bnamnaidu/HL2-Companion-board-codec-and-Filter-/HL2_Companion.kicad_pcb

## KiCad design HL2_Companion.kicad_pcb (2018-02-08)

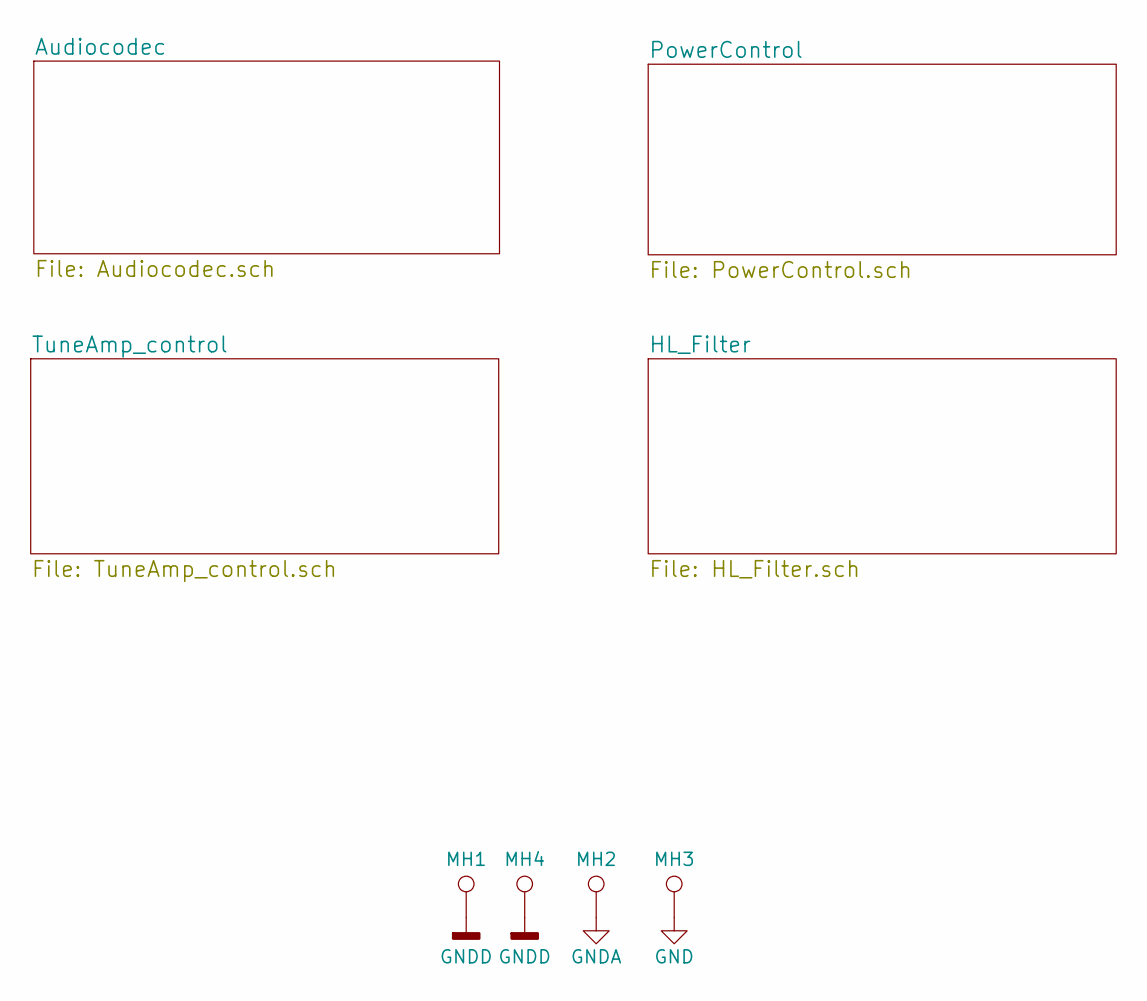
[picture p6: schematic HL2_Companion.sch, HL2Beta5_Companion]

Parts:
MH1, MH2, MH3, MH4: TEST_1P; m3

Connections:
GND: MH3.1; also elsewhere on the board
GNDA: MH2.1; also elsewhere on the board
GNDD: MH1.1, MH4.1; also elsewhere on the board

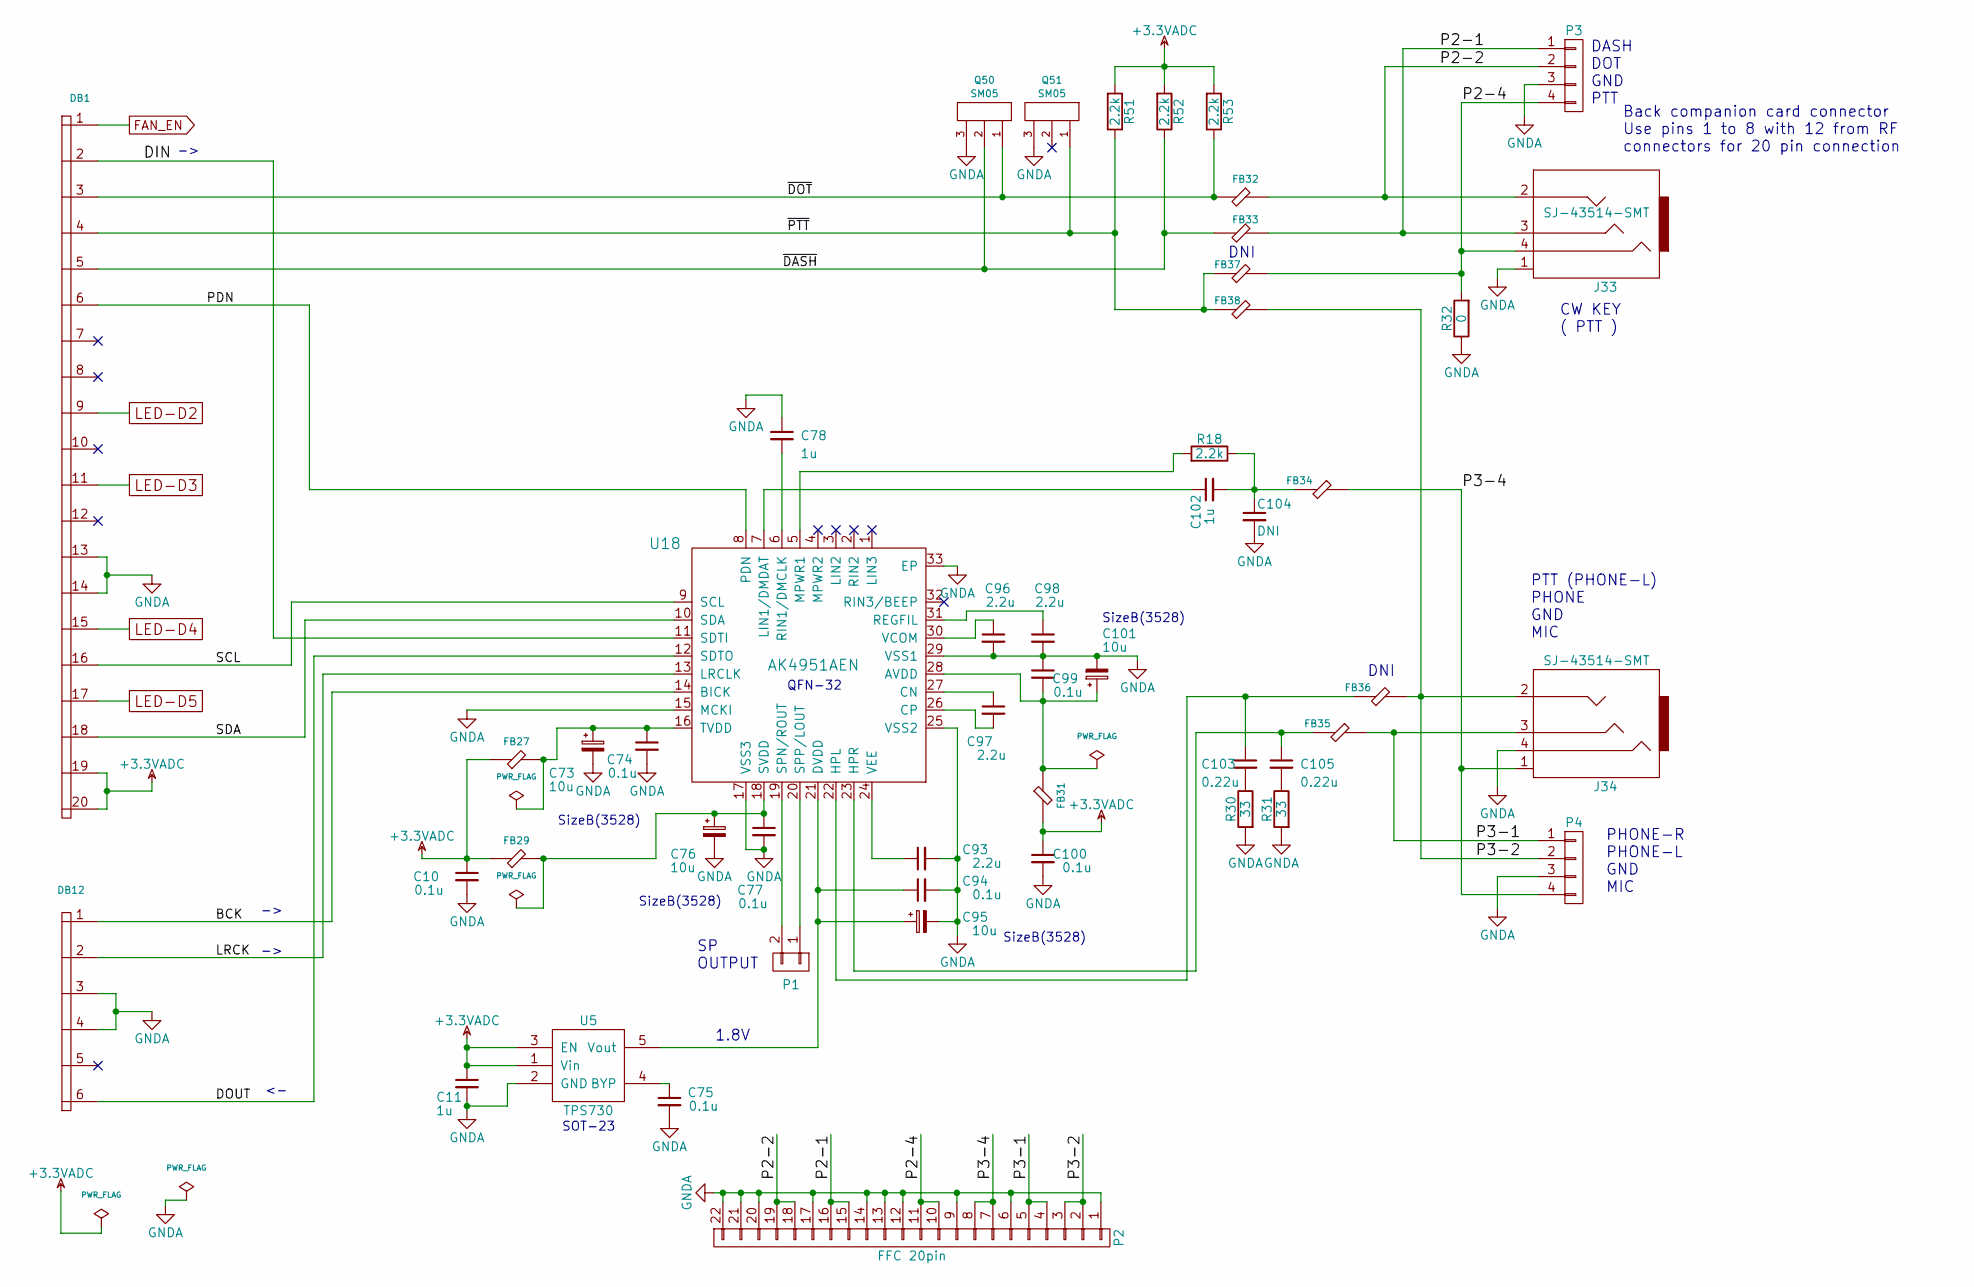
[picture p7: schematic Audiocodec.sch, H-L v2 Companion - AK4951]

Parts:
C10, C74, C75, C77, C94, C99, C100: 0.1u; C_0603_HandSoldering
C11, C78, C102: 1u; C_0603_HandSoldering
C73, C76, C95, C101: 10u; TantalC_SizeB_EIA-3528_Wave
C93, C96, C97, C98: 2.2u; C_0603_HandSoldering
C103, C105: 0.22u; C_0603_HandSoldering
C104: DNI; C_0603_HandSoldering
DB1: IO20; 10x2
DB12: IO6b; 3x2
FB27, FB29, FB31, FB32, FB33, FB34, FB35, FB36, FB37, FB38: FB; C_0603_HandSoldering
J33, J34: SJ-43514-SMT
P1: CONN_01X02; Pin_Header_Straight_1x02_Pitch2.54mm
P2: FFC 20pin; FFC_Kyocera_20pin
P3, P4: CONN_01X04; Pin_Header_Straight_1x04_Pitch2.54mm
Q50, Q51: SM05; SOT-23
R18, R51, R52, R53: 2.2k; C_0603_HandSoldering
R30, R31: 33; C_0603_HandSoldering
R32: 0; C_0603_HandSoldering
U5: TPS730; SOT23
U18: AK4951AEN; QFN-32-1EP_4x4mm_Pitch0.4mm_Handsoldering

Connections:
+3.3VADC: C10.1, C11.1, C100.1, DB1.19, DB1.20, FB27.2, FB29.2, FB31.1, R51.2, R52.2, R53.2, U5.1 (Vin), U5.3 (EN)
/Audiocodec/BCK: DB12.1, U18.14 (BICK)
/Audiocodec/DIN: DB1.2, U18.11 (SDTI)
/Audiocodec/DOUT: DB12.6, U18.12 (SDTO)
/Audiocodec/LRCK: DB12.2, U18.13 (LRCLK)
/Audiocodec/P2-1: FB33.2, J33.3, P2.15, P2.16, P3.1
/Audiocodec/P2-2: FB32.2, J33.2, P2.18, P2.19, P3.2
/Audiocodec/P2-4: FB37.1, J33.4, P2.10, P2.11, P3.4, R32.2
/Audiocodec/P3-1: FB35.2, J34.3, P2.4, P2.5, P4.1
/Audiocodec/P3-2: FB36.1, FB38.1, J34.2, P2.2, P2.3, P4.2
/Audiocodec/P3-4: FB34.2, J34.1, P2.7, P2.8, P4.4
/Audiocodec/PDN: DB1.6, U18.8 (PDN)
/Audiocodec/SCL: DB1.16, U18.9 (SCL)
/Audiocodec/SDA: DB1.18, U18.10 (SDA)
/Audiocodec/~DASH: DB1.5, FB33.1, Q50.2, R52.1
/Audiocodec/~DOT: DB1.3, FB32.1, Q50.1, R53.1
/Audiocodec/~PTT: DB1.4, FB37.2, FB38.2, Q51.1, R51.1
FAN_EN: DB1.1; also elsewhere on the board
GNDA: C10.2, C11.2, C73.2, C74.2, C75.2, C76.2, C77.2, C78.1, C93.2, C94.2, C95.2, C96.2, C98.2, C99.1, C100.2, C101.2, C104.2, DB1.13, DB1.14, DB12.3, DB12.4, J33.1, J34.4, P2.1, P2.6, P2.9, P2.12, P2.13, P2.14, P2.17, P2.20, P2.21, P2.22, P3.3, P4.3, Q50.3, Q51.3, R30.2, R31.2, R32.1, U5.2 (GND), U18.15 (MCKI), U18.17 (VSS3), U18.25 (VSS2), U18.29 (VSS1), U18.33 (EP); also elsewhere on the board
LED-D2: DB1.9; also elsewhere on the board
LED-D3: DB1.11; also elsewhere on the board
LED-D4: DB1.15; also elsewhere on the board
LED-D5: DB1.17; also elsewhere on the board
unnamed: C73.1, C74.1, FB27.1, U18.16 (TVDD)
unnamed: C75.1, U5.4 (BYP)
unnamed: C76.1, C77.1, FB29.1, U18.18 (SVDD)
unnamed: C78.2, U18.6 (RIN1/DMCLK)
unnamed: C93.1, U18.24 (VEE)
unnamed: C94.1, C95.1, U5.5 (Vout), U18.21 (DVDD)
unnamed: C96.1, U18.30 (VCOM)
unnamed: C97.1, U18.27 (CN)
unnamed: C97.2, U18.26 (CP)
unnamed: C98.1, U18.31 (REGFIL)
unnamed: C99.2, C101.1, FB31.2, U18.28 (AVDD)
unnamed: C102.1, U18.7 (LIN1/DMDAT)
unnamed: C102.2, C104.1, FB34.1, R18.1
unnamed: C103.1, FB36.2, U18.22 (HPL)
unnamed: C103.2, R30.1
unnamed: C105.1, FB35.1, U18.23 (HPR)
unnamed: C105.2, R31.1
unnamed: P1.1, U18.20 (SPP/LOUT)
unnamed: P1.2, U18.19 (SPN/ROUT)
unnamed: R18.2, U18.5 (MPWR1)

Notes on the sheet:
Back companion card connector Use pins 1 to 8 with 12 from RF connectors for 20 pin connection
SP OUTPUT
CW KEY ( PTT )
PTT (PHONE-L) PHONE GND MIC
1.8V
DNI
PHONE-R PHONE-L GND MIC
DASH DOT GND PTT
SizeB(3528)
SOT-23
QFN-32

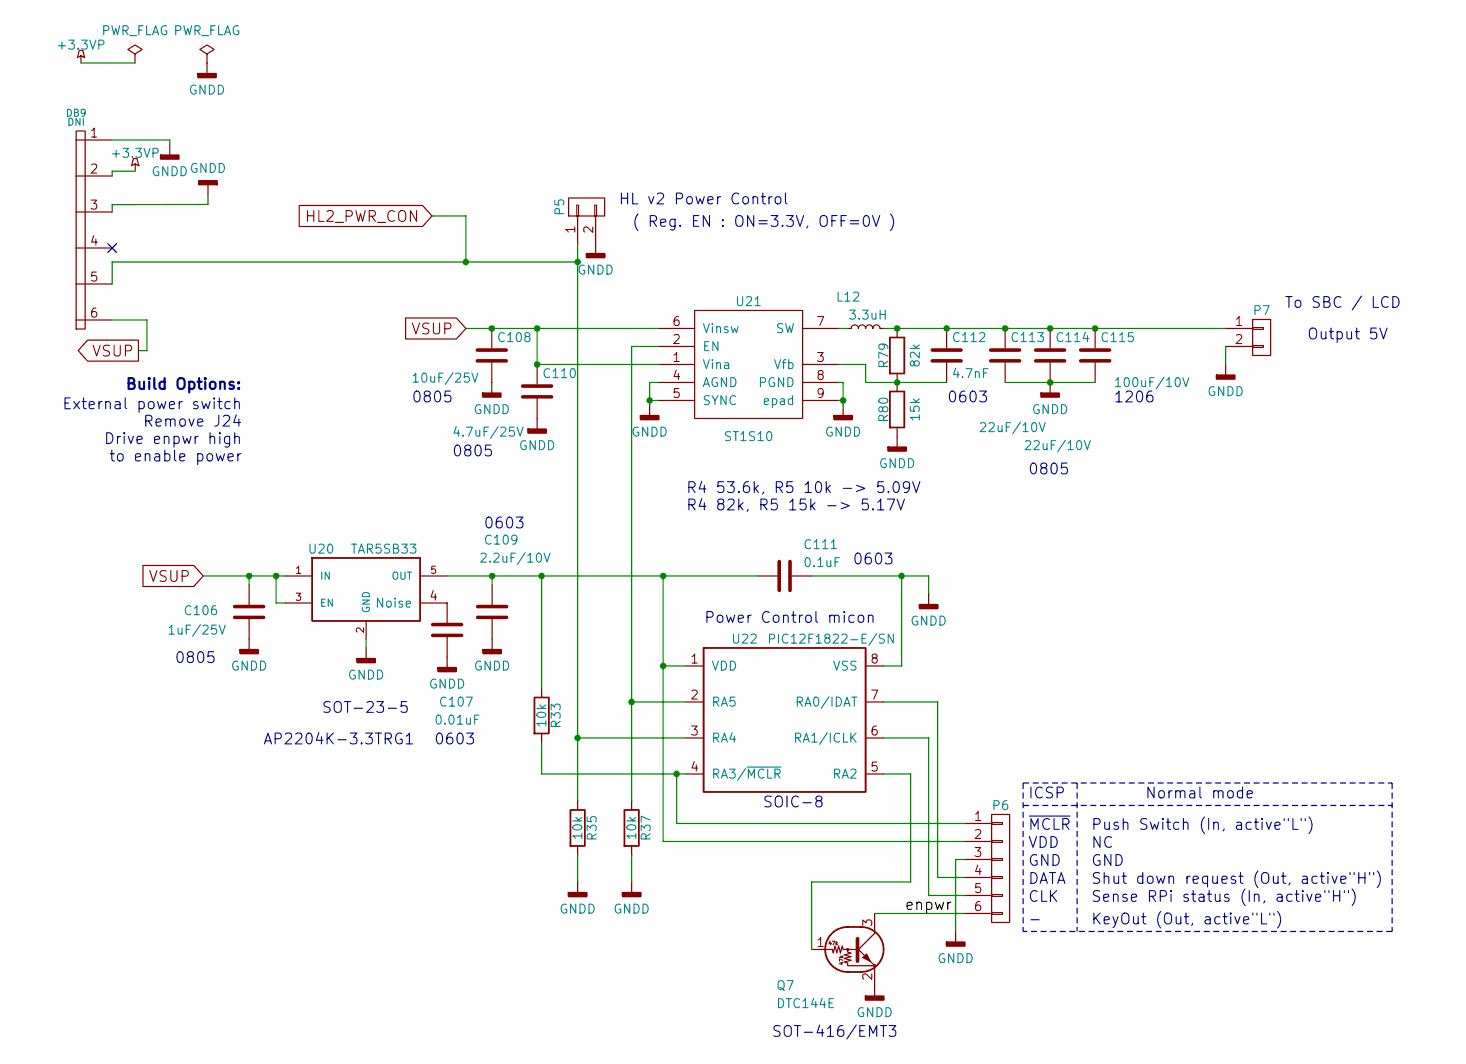
[picture p8: schematic PowerControl.sch, HL2Beta5_ PwrControl]

Parts:
C106: 1uF/25V; SMD-0805
C107: 0.01uF; SMD-0603
C108: 10uF/25V; SMD-0805
C109: 2.2uF/10V; SMD-0603
C110: 4.7uF/25V; SMD-0805
C111: 0.1uF; SMD-0603
C112: 4.7nF; SMD-0603
C113, C114: 22uF/10V; SMD-0805
C115: 100uF/10V; SMD-1206
DB9: IO6b; 6x1
L12: 3.3uH; GENERICPSL
P5: CONN_01X02; Pin_Header_Straight_1x02_Pitch2.54mm
P6: CONN_01X06; Pin_Header_Straight_1x06_Pitch2.54mm
P7: CONN_01X02; PINHEAD1-2
Q7: DTC144E; SOT416
R33, R35, R37: 10k; SMD-0603
R79: 82k; SMD-0603
R80: 15k; SMD-0603
U20: TAR5SB33; SOT-23-5
U21: ST1S10
U22: PIC12F1822-E/SN; SOIC-8_3.9x4.9mm_Pitch1.27mm

Connections:
+3.3VP: DB9.2; also elsewhere on the board
/PowerControl/enpwr: P6.6, Q7.3 (C)
GNDD: C106.2, C107.2, C108.2, C109.2, C110.2, C111.1, C113.2, C114.2, C115.2, DB9.1, DB9.3, P5.2, P6.3, P7.2, Q7.2 (E), R35.2, R37.2, R80.2, U20.2 (GND), U21.4 (AGND), U21.5 (SYNC), U21.8 (PGND), U21.9 (epad), U22.8 (VSS); also elsewhere on the board
HL2_PWR_CON: DB9.5, P5.1, R35.1, U22.3 (RA4); also elsewhere on the board
unnamed: C107.1, U20.4 (Noise)
unnamed: C109.1, C111.2, P6.2, R33.1, U20.5 (OUT), U22.1 (VDD)
unnamed: C112.1, C113.1, C114.1, C115.1, L12.1, P7.1, R79.1
unnamed: C112.2, R79.2, R80.1, U21.3 (Vfb)
unnamed: L12.2, U21.7 (SW)
unnamed: P6.1, R33.2, U22.4 (RA3/~MCLR)
unnamed: P6.4, U22.7 (RA0/IDAT)
unnamed: P6.5, U22.6 (RA1/ICLK)
unnamed: Q7.1 (B), U22.5 (RA2)
unnamed: R37.1, U21.2 (EN), U22.2 (RA5)
VSUP: C106.1, C108.1, C110.1, DB9.6, U20.1 (IN), U20.3 (EN), U21.1 (Vina), U21.6 (Vinsw); also elsewhere on the board

Notes on the sheet:
To SBC / LCD
ICSP
~MCLR
VDD
GND
DATA
CLK
Shut down request (Out, active"H")
Sense RPi status (In, active"H")
Output 5V
Normal mode
Push Switch (In, active"L")
HL v2 Power Control
( Reg. EN : ON=3.3V, OFF=0V )
Power Control micon
SOT-23-5
SOIC-8
0805
1206
0603
SOT-416/EMT3
R4 53.6k, R5 10k -> 5.09V R4 82k, R5 15k -> 5.17V
AP2204K-3.3TRG1
KeyOut (Out, active"L")
Build Options:
External power switch Remove J24 Drive enpwr high to enable power

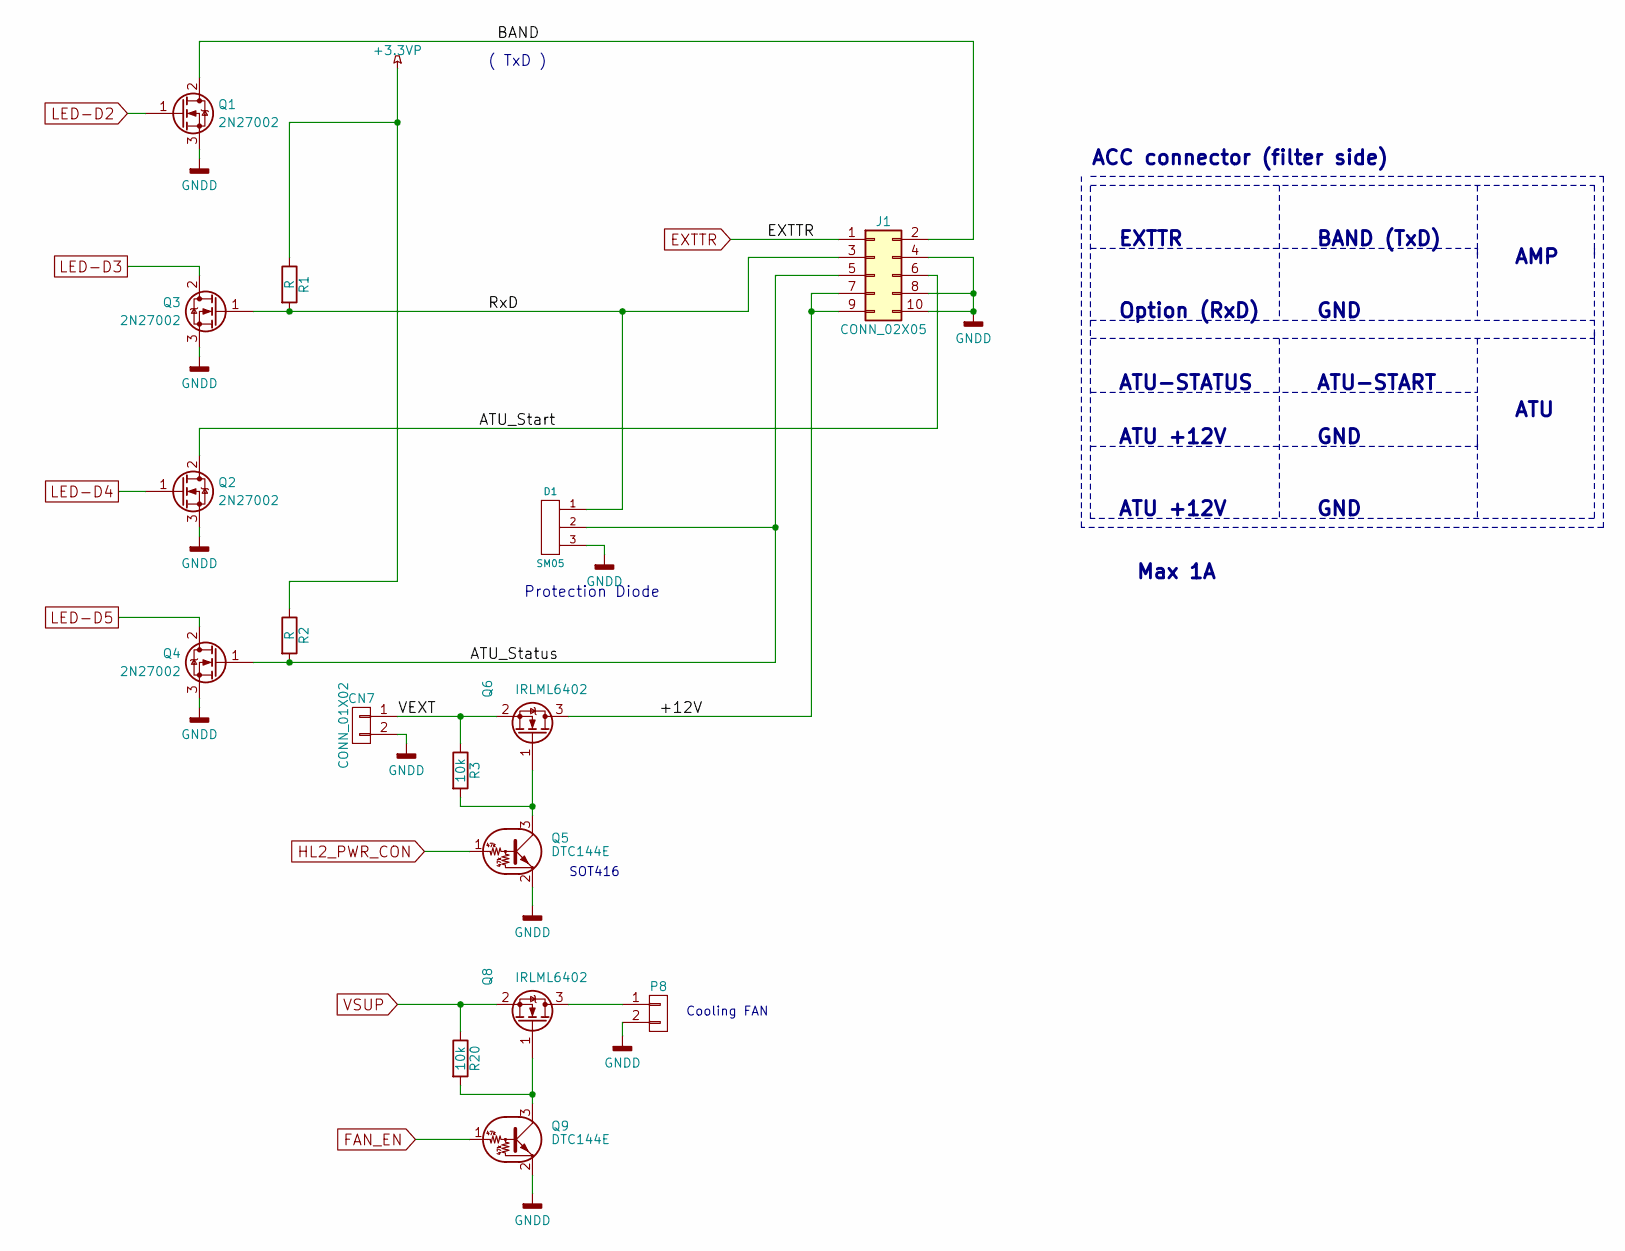
[picture p9: schematic TuneAmp_control.sch, HL2 Companion/Tuner Amplifier Control]

Parts:
CN7: CONN_01X02; CN7
D1: SM05; SOT-23
J1: CONN_02X05; 5x2
P8: CONN_01X02; PINHEAD1-2
Q1, Q2, Q3, Q4: 2N27002; SOT-23
Q5, Q9: DTC144E; SOT416
Q6, Q8: IRLML6402; SOT23_3
R1, R2: R; C_0603_HandSoldering
R3, R20: 10k; C_0603_HandSoldering

Connections:
+3.3VP: R1.1, R2.1; also elsewhere on the board
/TuneAmp_control/+12V: J1.7, J1.9, Q6.3 (D)
/TuneAmp_control/ATU_Start: J1.6, Q2.2 (D)
/TuneAmp_control/ATU_Status: D1.2, J1.5, Q4.1 (G), R2.2
/TuneAmp_control/BAND: J1.2, Q1.2 (D)
/TuneAmp_control/RxD: D1.1, J1.3, Q3.1 (G), R1.2
/TuneAmp_control/VEXT: CN7.1, Q6.2 (S), R3.1
EXTTR: J1.1; also elsewhere on the board
FAN_EN: Q9.1 (B); also elsewhere on the board
GNDD: CN7.2, D1.3, J1.4, J1.8, J1.10, P8.2, Q1.3 (S), Q2.3 (S), Q3.3 (S), Q4.3 (S), Q5.2 (E), Q9.2 (E); also elsewhere on the board
HL2_PWR_CON: Q5.1 (B); also elsewhere on the board
LED-D2: Q1.1 (G); also elsewhere on the board
LED-D3: Q3.2 (D); also elsewhere on the board
LED-D4: Q2.1 (G); also elsewhere on the board
LED-D5: Q4.2 (D); also elsewhere on the board
unnamed: P8.1, Q8.3 (D)
unnamed: Q5.3 (C), Q6.1 (G), R3.2
unnamed: Q8.1 (G), Q9.3 (C), R20.2
VSUP: Q8.2 (S), R20.1; also elsewhere on the board

Notes on the sheet:
( TxD )
Protection Diode
EXTTR
BAND (TxD)
Option (RxD)
GND
AMP
ATU-STATUS
ATU-START
ATU +12V
ATU
Max 1A
ACC connector (filter side)
SOT416
Cooling FAN

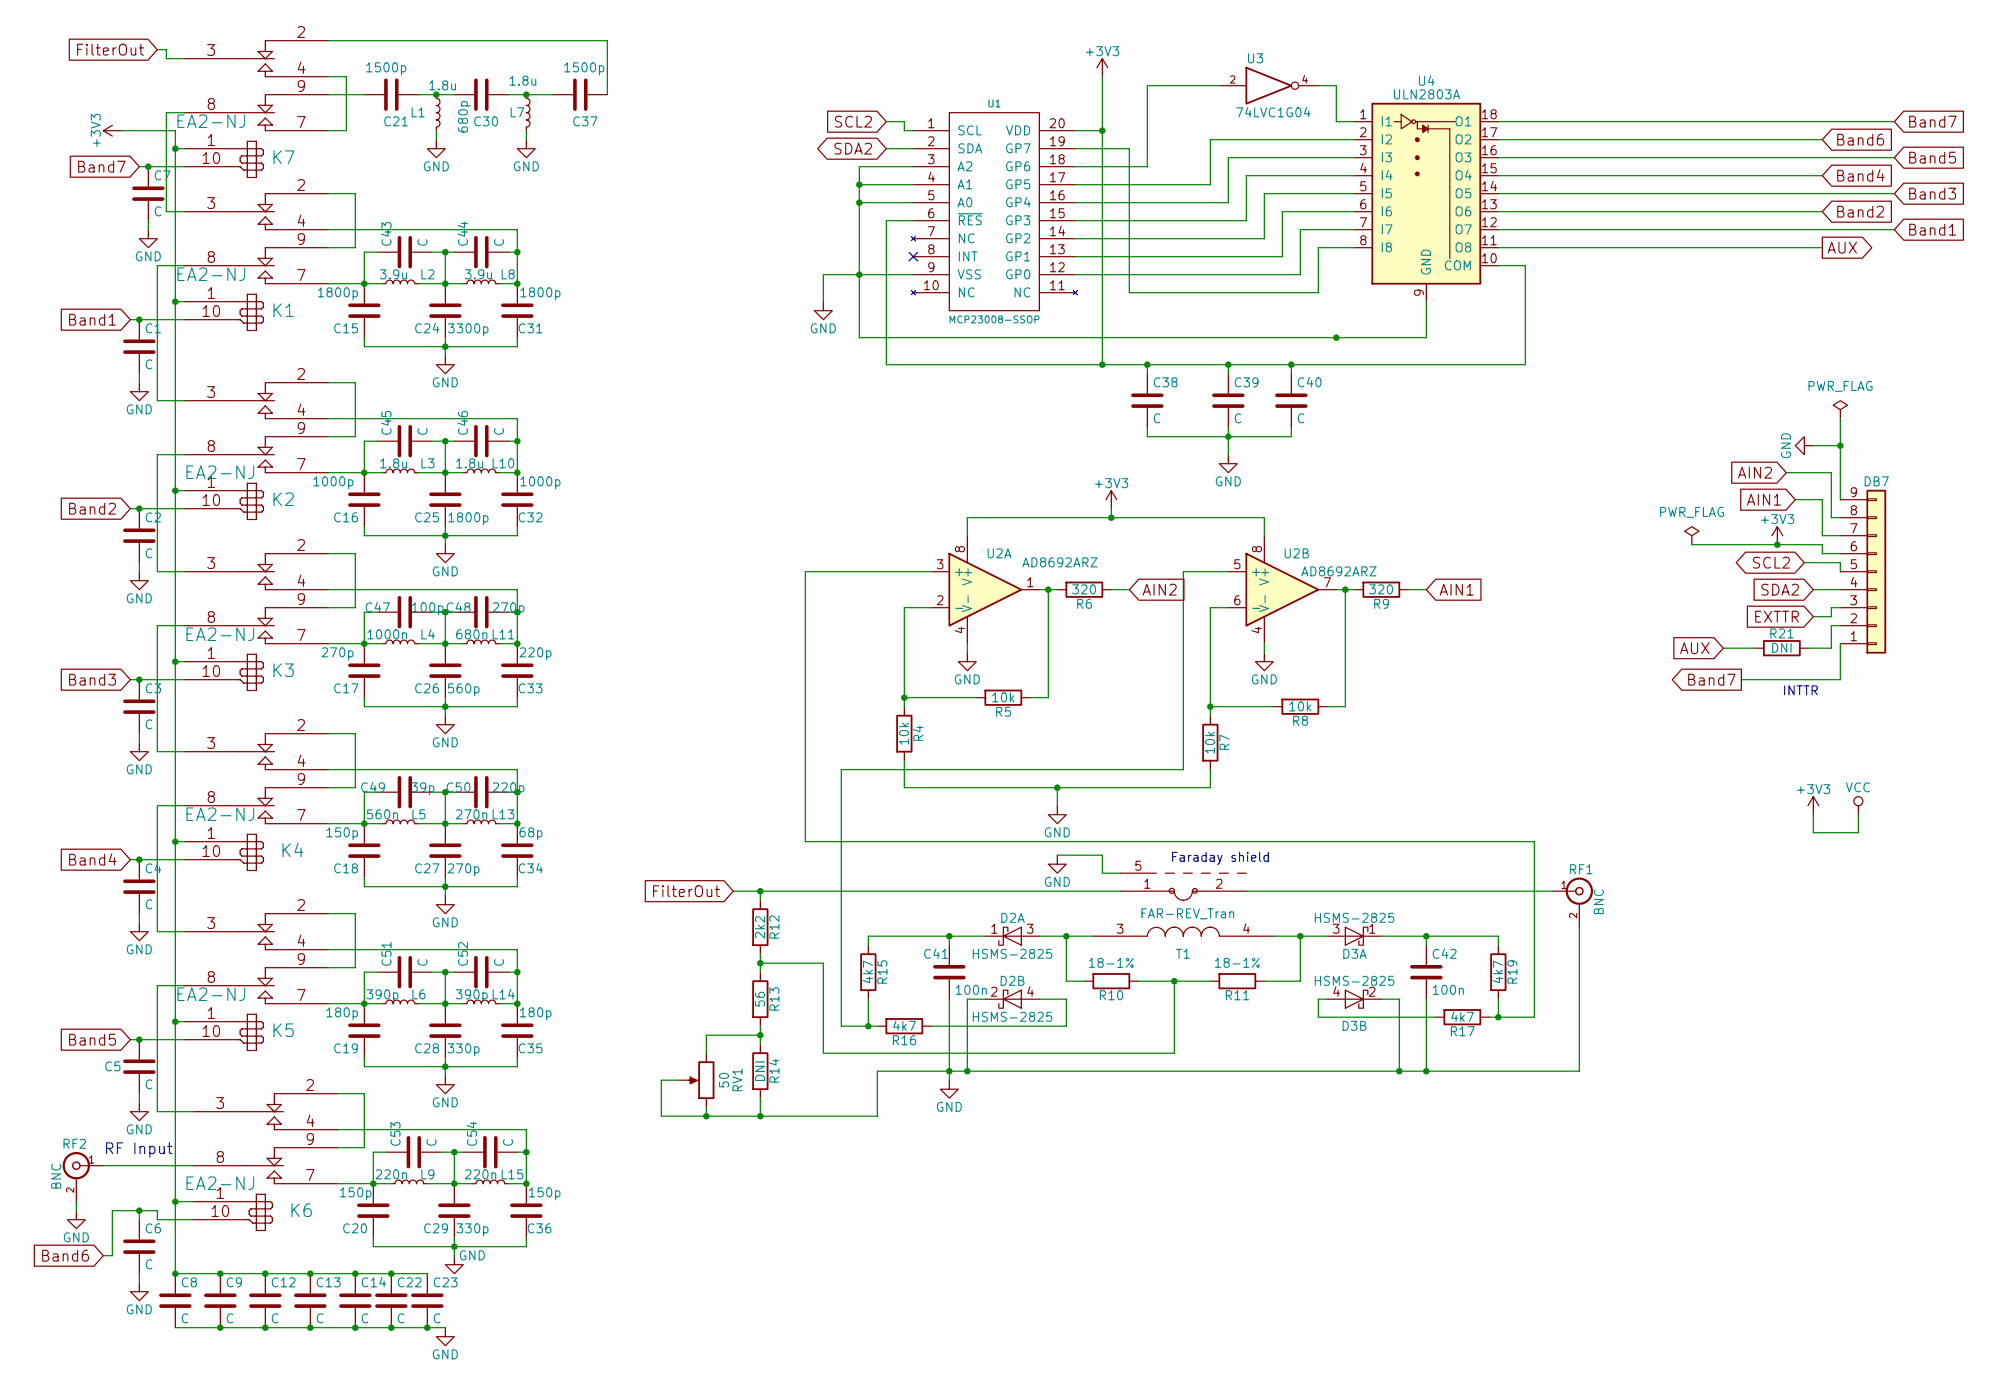
[picture p10: schematic HL_Filter.sch, Hermes Lite Companion-Filter]

Parts:
C1, C2, C3, C4, C5, C6, C7, C8, C9, C12, C13, C14, C22, C23, C38, C39, C40, C43, C44, C45, C46, C51, C52, C53, C54: C; C_0805_HandSoldering
C15, C25, C31: 1800p; C_0805_HandSoldering
C16, C32: 1000p; C_0805_HandSoldering
C17, C27, C48: 270p; C_0805_HandSoldering
C18, C20, C36: 150p; C_0805_HandSoldering
C19, C35: 180p; C_0805_HandSoldering
C21, C37: 1500p; C_0805_HandSoldering
C24: 3300p; C_0805_HandSoldering
C26: 560p; C_0805_HandSoldering
C28, C29: 330p; C_0805_HandSoldering
C30: 680p; C_0805_HandSoldering
C33, C50: 220p; C_0805_HandSoldering
C34: 68p; C_0805_HandSoldering
C41, C42: 100n; C_0805_HandSoldering
C47: 100p; C_0805_HandSoldering
C49: 39p; C_0805_HandSoldering
D2, D3: HSMS-2825; SOT-143
DB7: IO9; 9x1
K1, K2, K3, K4, K5, K6, K7: EA2-NJ; Relay_EA2
L1, L3, L7, L10: 1.8u; Toroid_Horizontal-T30
L2, L8: 3.9u; Toroid_Horizontal-T30
L4: 1000n; Toroid_Horizontal-T30
L5: 560n; Toroid_Horizontal-T30
L6, L14: 390p; Toroid_Horizontal-T30
L9, L15: 220n; Toroid_Horizontal-T30
L11: 680n; Toroid_Horizontal-T30
L13: 270n; Toroid_Horizontal-T30
R4, R5, R7, R8: 10k; R_0805_HandSoldering
R6, R9: 320; R_0805_HandSoldering
R10, R11: 18-1%; R_0805_HandSoldering
R12: 2k2; R_0805_HandSoldering
R13: 56; R_0805_HandSoldering
R14, R21: DNI; R_0805_HandSoldering
R15, R16, R17, R19: 4k7; R_0805_HandSoldering
RF1, RF2: BNC; SMAEDGE_TH_R
RV1: 50; Potentiometer_Trimmer-EVM3E
T1: FAR-REV_Tran
U1: MCP23008-SSOP; SOIC-20W_7.5x12.8mm_Pitch1.27mm
U2: AD8692ARZ; SO-8_5.3x6.2mm_Pitch1.27mm
U3: 74LVC1G04; SOT-353_SC-70-5_Handsoldering
U4: ULN2803A; SOIC-18W_7.5x11.6mm_Pitch1.27mm

Connections:
+3V3: C8.1, C9.1, C12.1, C13.1, C14.1, C22.1, C23.1, C38.1, C39.1, C40.1, DB7.6, K1.1, K2.1, K3.1, K4.1, K5.1, K6.1, K7.1, U1.6 (~RES), U1.20 (VDD), U2.8 (V+), U3.5 (VCC), U4.10 (COM)
AIN1: DB7.7, R9.1
AIN2: DB7.8, R6.1
AUX: R21.2, U4.11 (O8)
Band1: C1.1, K1.10, U4.12 (O7)
Band2: C2.1, K2.10, U4.13 (O6)
Band3: C3.1, K3.10, U4.14 (O5)
Band4: C4.1, K4.10, U4.15 (O4)
Band5: C5.1, K5.10, U4.16 (O3)
Band6: C6.1, K6.10, U4.17 (O2)
Band7: C7.1, DB7.1, K7.10, U4.18 (O1)
EXTTR: DB7.3; also elsewhere on the board
FilterOut: K7.3 (C2), R12.1, T1.1 (PR2)
GND: C1.2, C2.2, C3.2, C4.2, C5.2, C6.2, C7.2, C8.2, C9.2, C12.2, C13.2, C14.2, C15.1, C16.1, C17.1, C18.1, C19.1, C20.1, C22.2, C23.2, C24.1, C25.1, C26.1, C27.1, C28.1, C29.1, C31.1, C32.1, C33.1, C34.1, C35.1, C36.1, C38.2, C39.2, C40.2, C41.2, C42.2, D2.2 (K), D3.2 (K), DB7.9, L1.2, L7.2, R4.2, R7.2, R14.2, RF1.2 (Ext), RF2.2 (Ext), RV1.1, RV1.2, T1.5 (GND), U1.3 (A2), U1.4 (A1), U1.5 (A0), U1.9 (VSS), U2.4 (V-), U3.3 (GND), U4.9 (GND); also elsewhere on the board
unnamed: C15.2, C43.1, K1.7 (T1), L2.2
unnamed: C16.2, C45.1, K2.7 (T1), L3.2
unnamed: C17.2, C47.1, K3.7 (T1), L4.2
unnamed: C18.2, C49.1, K4.7 (T1), L5.2
unnamed: C19.2, C51.1, K5.7 (T1), L6.2
unnamed: C20.2, C53.1, K6.7 (T1), L9.2
unnamed: C21.1, C30.2, L1.1
unnamed: C21.2, K7.9 (R1)
unnamed: C24.2, C43.2, C44.1, L2.1, L8.1
unnamed: C25.2, C45.2, C46.1, L3.1, L10.1
unnamed: C26.2, C47.2, C48.1, L4.1, L11.1
unnamed: C27.2, C49.2, C50.1, L5.1, L13.1
unnamed: C28.2, C51.2, C52.1, L6.1, L14.1
unnamed: C29.2, C53.2, C54.1, L9.1, L15.1
unnamed: C30.1, C37.2, L7.1
unnamed: C31.2, C44.2, K1.4 (T2), L8.2
unnamed: C32.2, C46.2, K2.4 (T2), L10.2
unnamed: C33.2, C48.2, K3.4 (T2), L11.2
unnamed: C34.2, C50.2, K4.4 (T2), L13.2
unnamed: C35.2, C52.2, K5.4 (T2), L14.2
unnamed: C36.2, C54.2, K6.4 (T2), L15.2
unnamed: C37.1, K7.2 (R2)
unnamed: C41.1, D2.1 (K), R15.1
unnamed: C42.1, D3.1 (K), R19.1
unnamed: D2.3 (A), R10.2, T1.3 (S1)
unnamed: D2.4 (A), R16.1
unnamed: D3.3 (A), R11.1, T1.4 (S2)
unnamed: D3.4 (A), R17.2
unnamed: DB7.2, R21.1
unnamed: K1.2 (R2), K1.9 (R1)
unnamed: K1.3 (C2), K7.8 (C1)
unnamed: K1.8 (C1), K2.3 (C2)
unnamed: K2.2 (R2), K2.9 (R1)
unnamed: K2.8 (C1), K3.3 (C2)
unnamed: K3.2 (R2), K3.9 (R1)
unnamed: K3.8 (C1), K4.3 (C2)
unnamed: K4.2 (R2), K4.9 (R1)
unnamed: K4.8 (C1), K5.3 (C2)
unnamed: K5.2 (R2), K5.9 (R1)
unnamed: K5.8 (C1), K6.3 (C2)
unnamed: K6.2 (R2), K6.9 (R1)
unnamed: K6.8 (C1), RF2.1 (In)
unnamed: K7.4 (T2), K7.7 (T1)
unnamed: R4.1, R5.2, U2.2 (-)
unnamed: R5.1, R6.2, U2.1
unnamed: R7.1, R8.2, U2.6 (-)
unnamed: R8.1, R9.2, U2.7
unnamed: R10.1, R11.2, R12.2, R13.1
unnamed: R13.2, R14.1, RV1.3
unnamed: R15.2, R16.2, U2.5 (+)
unnamed: R17.1, R19.2, U2.3 (+)
unnamed: RF1.1 (In), T1.2 (PR1)
unnamed: U1.12 (GP0), U4.7 (I7)
unnamed: U1.13 (GP1), U4.6 (I6)
unnamed: U1.14 (GP2), U4.5 (I5)
unnamed: U1.15 (GP3), U4.4 (I4)
unnamed: U1.16 (GP4), U4.3 (I3)
unnamed: U1.17 (GP5), U4.2 (I2)
unnamed: U1.18 (GP6), U3.2
unnamed: U1.19 (GP7), U4.8 (I8)
unnamed: U3.4, U4.1 (I1)
SCL2: DB7.5, U1.1 (SCL)
SDA2: DB7.4, U1.2 (SDA)

Notes on the sheet:
RF Input
Faraday shield
INTTR

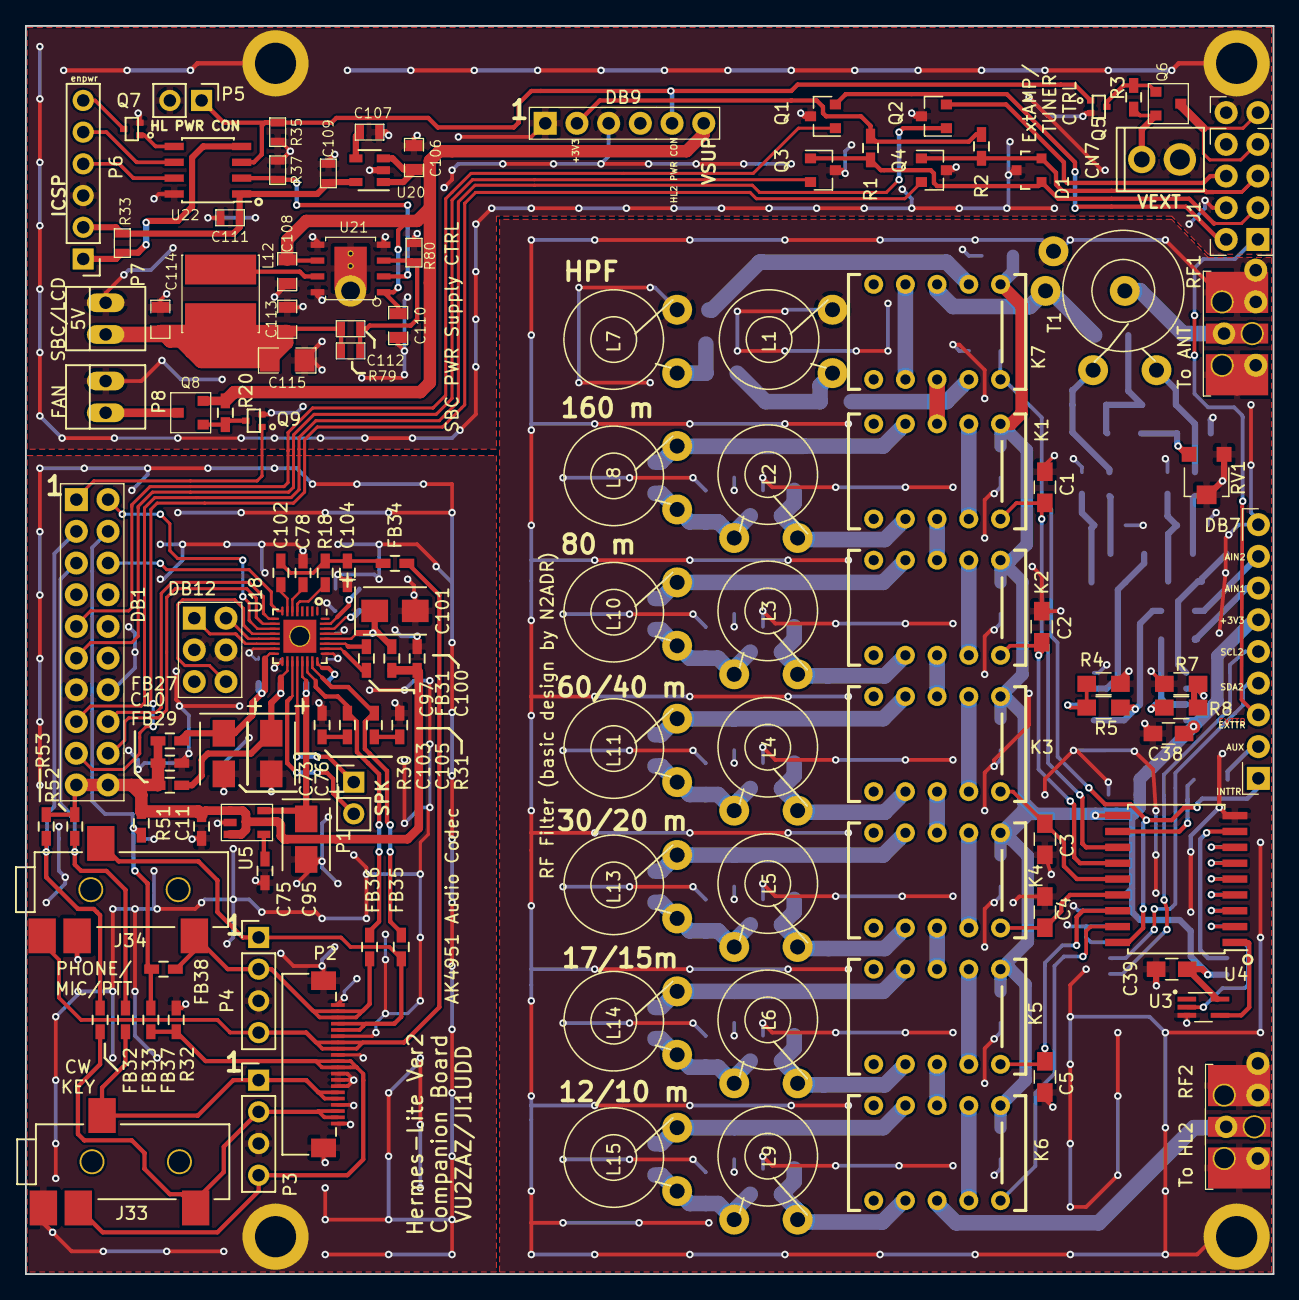
[picture p11: board HL2_Companion.kicad_pcb from above]

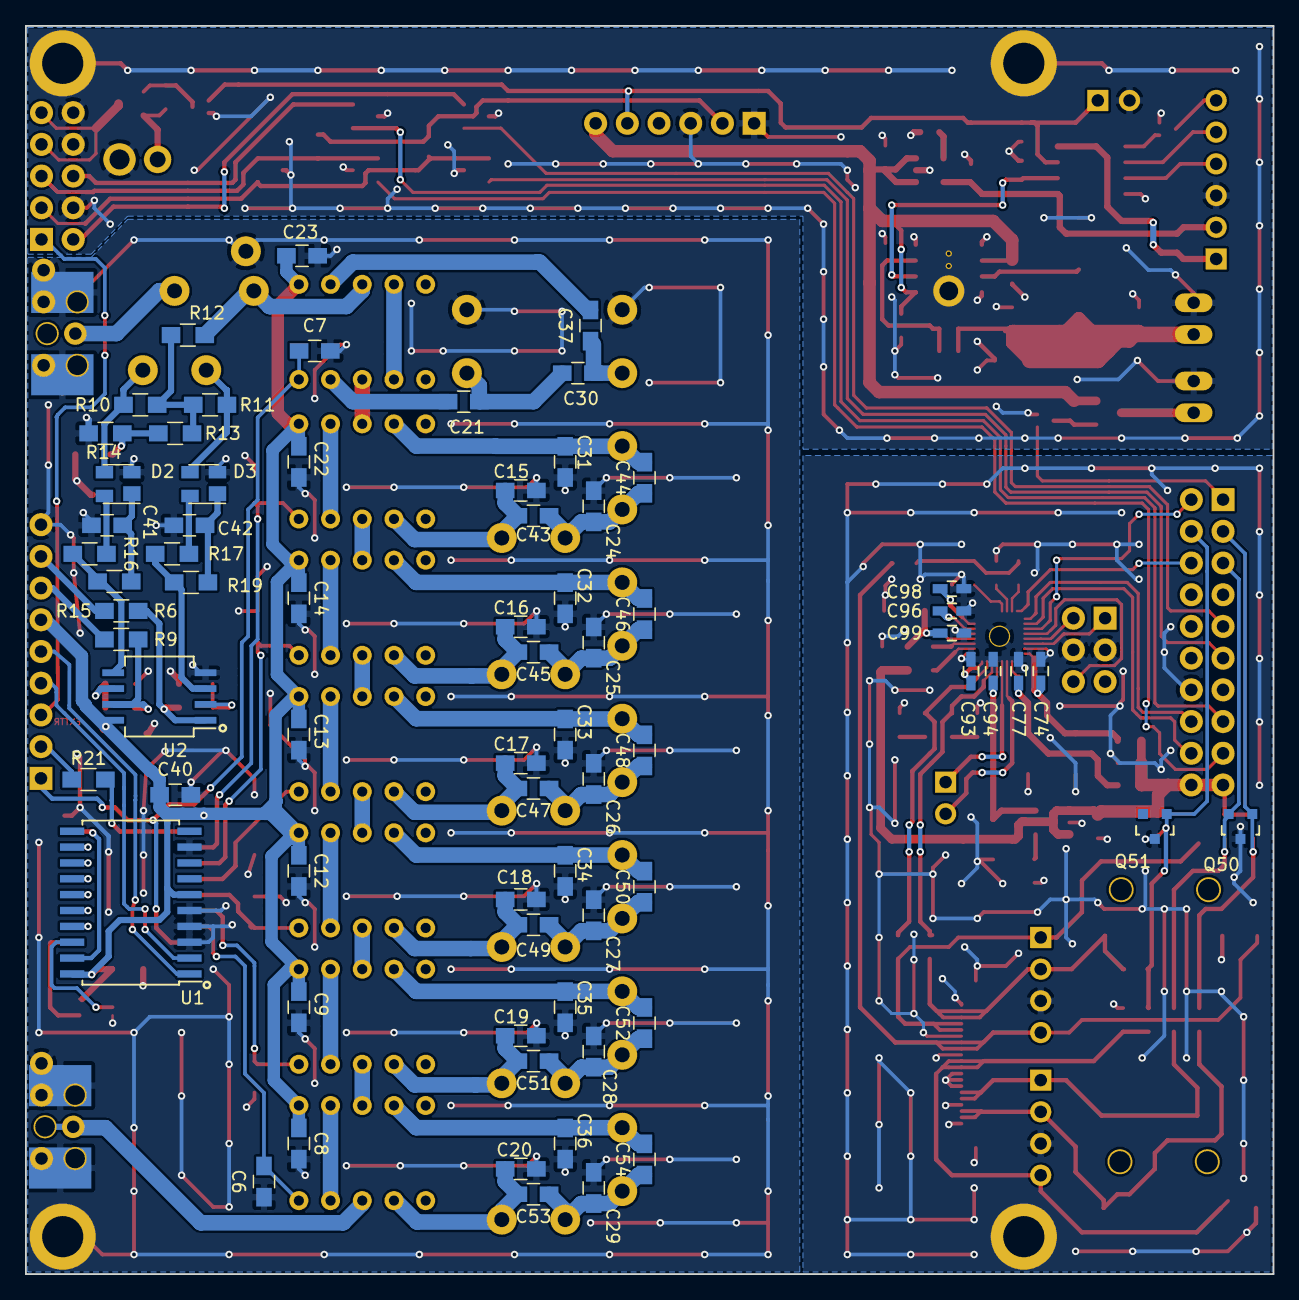
[picture p12: board HL2_Companion.kicad_pcb from below]

Board: 2 copper layers, 99.9 x 100.0 mm, 194 parts (70 on the bottom side), 144 nets.
