bnamnaidu/HL2-Companion-board-codec-and-Filter-/(commit log)

2018-02-07 2nd commit
    [Audiocodec-2018-01-16-07-36-30.sch, PowerControl-2018-01-16-07-36-30.sch, hermeslite-2018-01-16-07-36-30.sch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]
2018-02-07 Revert "2nd commit"
    This reverts commit c2c8c64dbba293bd2cada59ce21b839a84bcafa0.
    [Audiocodec-2018-01-16-07-36-30.sch, PowerControl-2018-01-16-07-36-30.sch, hermeslite-2018-01-16-07-36-30.sch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]
2018-02-07 Revert "Revert "2nd commit""
    This reverts commit edb932220130fd3fafe1bb85e67b4344efccf7b3.
    [Audiocodec-2018-01-16-07-36-30.sch, PowerControl-2018-01-16-07-36-30.sch, hermeslite-2018-01-16-07-36-30.sch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]
2018-02-07 deleted files
    [hermeslite.kicad_pcb]
2018-02-08 gerber corrected
2018-02-08 gerber modified
